pkurucz/opentelem_to_bst_bridge/docs/Arduino Nano - Board.jpg

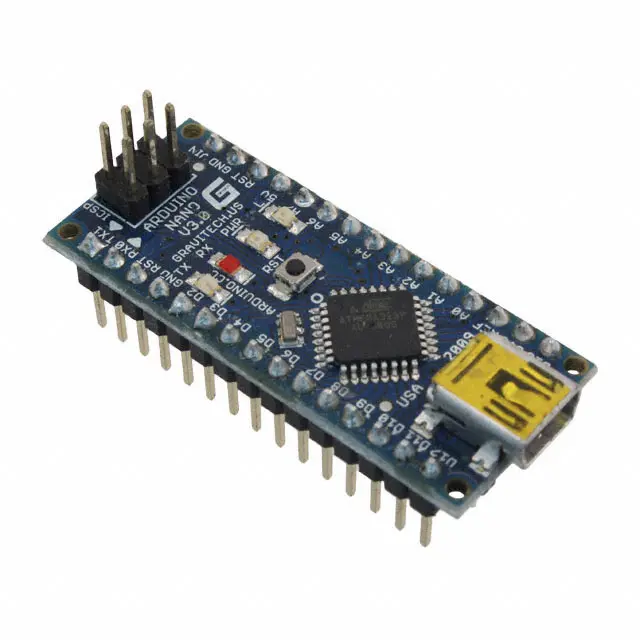
docs/Arduino Nano - Board.jpg
