pkurucz/opentelem_to_bst_bridge/docs/Arduino Nano - Schematic.png

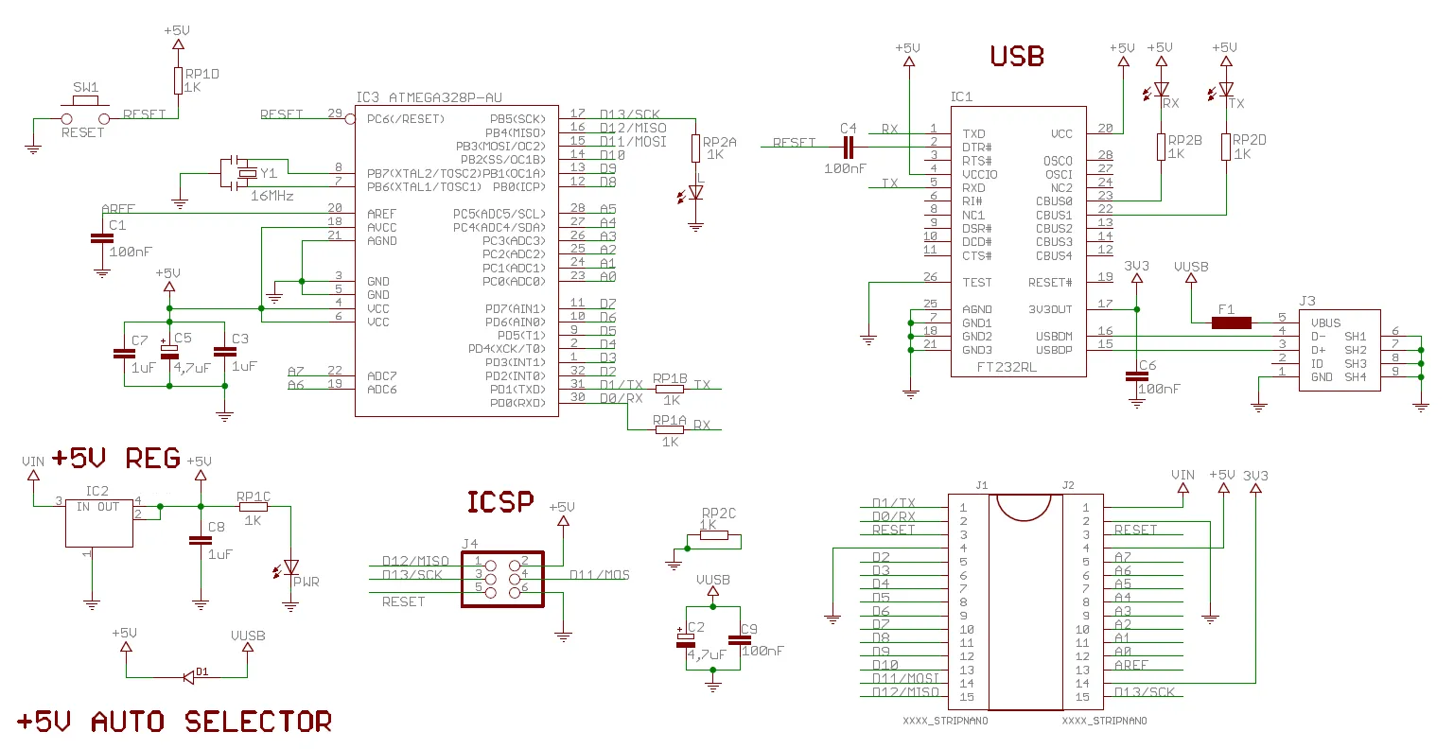
docs/Arduino Nano - Schematic.png
