pkurucz/opentelem_to_bst_bridge/docs/ArduinoNano-3.3.png

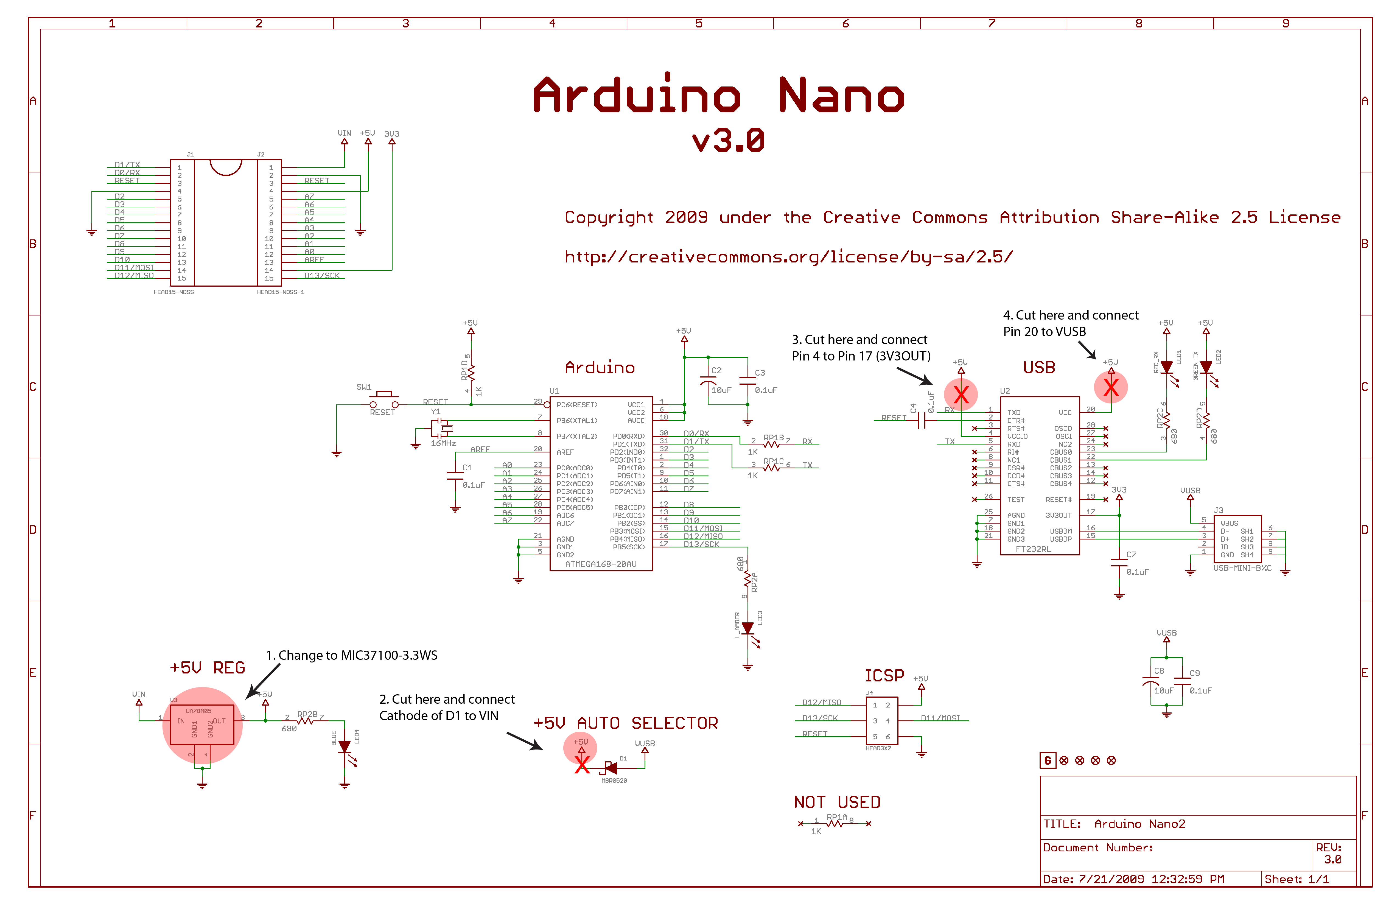
docs/ArduinoNano-3.3.png
