pkurucz/opentelem_to_bst_bridge/docs/Vector Opentelemetry.png

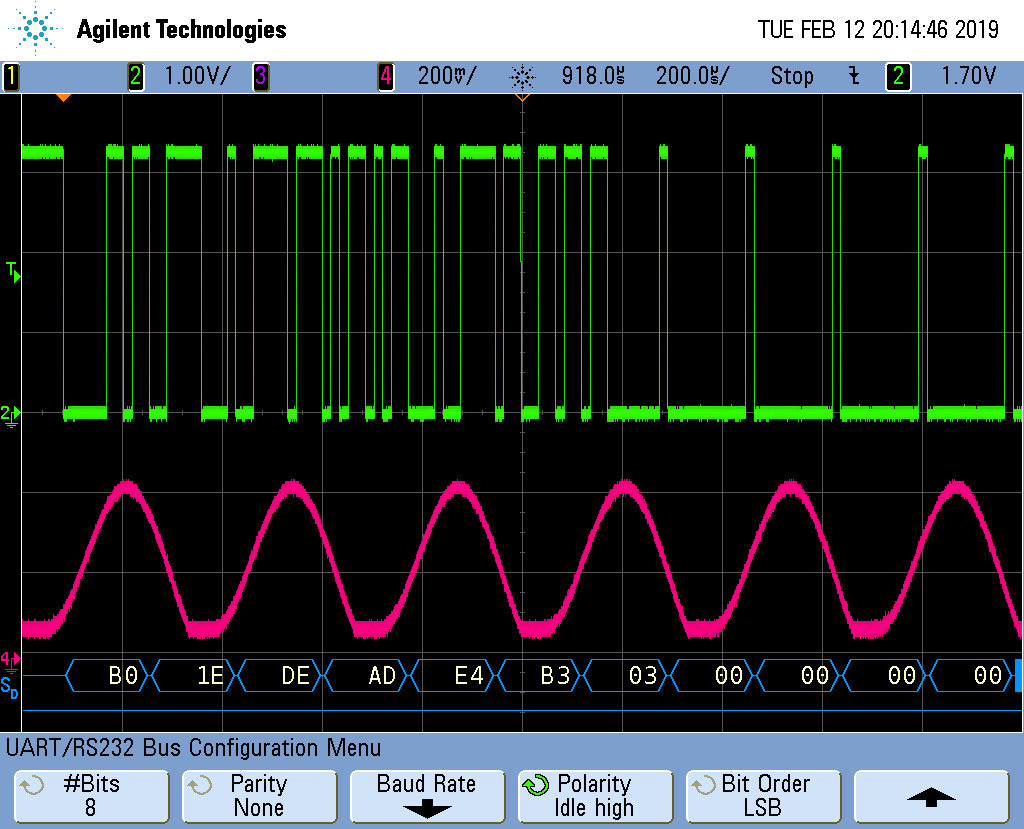
docs/Vector Opentelemetry.png
