pkurucz/opentelem_to_bst_bridge/docs/tbs_bst_wiring_pinout.png

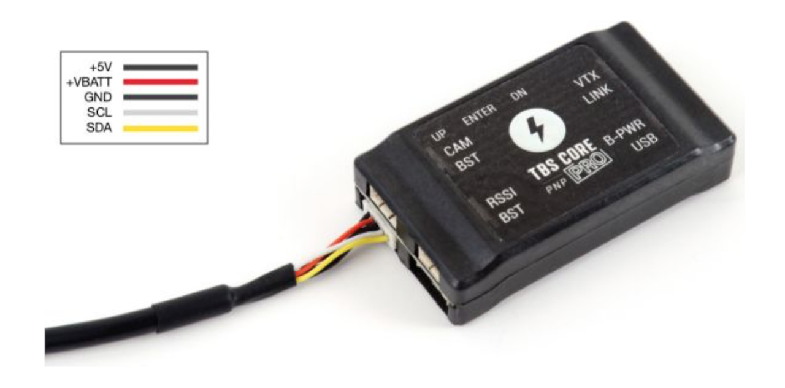
docs/tbs_bst_wiring_pinout.png
