pkurucz/opentelem_to_bst_bridge/(threads)

Thread 2 (2020-08-17):

Usage Help

CorruptName, 2020-08-17:
Is there any way I can use your code to implement a voltage reader for a simple plane?
I want to use an arduino pro mini to read 6s cell voltage and put it out to crossfire receiver's BST port.
Any suggestions? Is this doable?
Thanks!

PS: Thanks for all the work you have done!

pkurucz, 2020-08-17:
Should be very straight forward.  You need 2 resistors to make an external
voltage divider to scale vbatt to either 5V or 3.3V (depending on the
maximum ADC voltage you particular ATMega variant supports).  Read the
value with analogread() (
https://www.arduino.cc/reference/en/language/functions/analog-io/analogread/)
apply and calibration scaling and offset needed.  And look at the
function bst_write_vector_battery(void) in (
https://github.com/pkurucz/opentelem_to_bst_bridge/blob/master/bst_telemetry.cpp).
voltage is a uint16 and is 100 x the voltage.  So, 10.34V would be 1034.

~pk

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

CorruptName, 2020-08-18:
I was curious, How would I send the individual cell voltage?
Essentially I'm trying to re-create this:
[(https://hobbyking.com/en_us/frsky-flvss-lipo-voltage-sensor-with-smart-port-1pc.html?countrycode=US)]
But Instead of S.Port, It would have BST obviously.
I will be using the Arduino Pro Mini for now since it has 8 Analog Inputs (6 if you use A4 & A5 for I2C BST)
and I want to send the voltage data for all cells if possible. If It's not possible or too much work I will settle for combined voltage or maybe just divide total voltage by the number of supposed cells and send out the average cell voltage.

CorruptName, 2020-08-18:
After looking, It seems that Crossfire doesn't have "A4" or "Cell Voltage" only Bat % (which we can't use in BST according to your function notes) or RX Bat (total bat).
Do I have that right?
Thanks!

CorruptName, 2020-08-18:
After some testing, I find that I am unable to get any battery telemetry to the radio. everything seems be set up correctly, since I am getting GPS, GSpd, Hdg, Alt, Sats (though they are all zero) which are not present without arduino. What Am I missing? There is no OpenTelemetry input hooked up but I should still see zero, right?
Thanks, Ryan

CorruptName, 2020-08-19:
Thanks for your help and contribution. I was able to figure it out. If I have time, I may use some of your code to create a library for Arduino to make it easier for those who want to create their own sensors for Crossfire as I have done. If I do find time to create such a library I will certainly contribute it here since it would be derived from your code base.

BTW, It seems that "Bat_" (battery percent) does in fact work over BST unless i misunderstood the code comment.

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

Obviously the provided values are false but the rest is simple.
Thanks Again!
-Corrupt

pkurucz, 2020-08-19:
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

Shiny! Glad to see you got it working.  Sure, feel free to make a library out of the code.  wrt to the BAT%, yeah I saw it in the CRSF code and put it in there as a placeholder to test.  I didn't do it initially because the vector doesn't pass up the bettery percentage through opentelemetry.  Glad to see you can put it to use.

~pk

Giorgo961, 2021-03-12:
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

I need exactly the same thing, but I do not have experiences with Arduino programming. Can I use for it the board with APM32F103C with 128kB flash? And, please, could you send me your FW with this feature?

Giorgo961, 2021-03-29:
> Thanks for your help and contribution. I was able to figure it out. If I have time, I may use some of your code to create a library for Arduino to make it easier for those who want to create their own sensors for Crossfire as I have done. If I do find time to create such a library I will certainly contribute it here since it would be derived from your code base.
Did you have  time to create a library for Crossfire?

CorruptName, 2021-03-29:
I started it but I couldn't honestly tell you how far I made it at this
point. I know it's not finished tho.

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

Giorgo961, 2021-03-29:
> I started it but I couldn't honestly tell you how far I made it at this point. I know it's not finished tho.
> […](#)
> On Mon, Mar 29, 2021, 3:01 AM Giorgo961 ***@***.***> wrote: Thanks for your help and contribution. I was able to figure it out. If I have time, I may use some of your code to create a library for Arduino to make it easier for those who want to create their own sensors for Crossfire as I have done. If I do find time to create such a library I will certainly contribute it here since it would be derived from your code base. Did you have time to create a library for Crossfire? — You are receiving this because you modified the open/close state. Reply to this email directly, view it on GitHub <[#2 (comment)](https://github.com/pkurucz/opentelem_to_bst_bridge/issues/2#issuecomment-809124730)>, or unsubscribe <https://github.com/notifications/unsubscribe-auth/AGFWWL4NGVUXJPXHYNVQLCDTGAXWFANCNFSM4QBHQ4XA> .

OK, and may I ask you to send me the FW you created? I have already the same board 328P. I asked dgatf to create/modify his FW for Crossfire, but up to now it did not work. The board (as a master) sends some data to the receiver, but new sensors did not arrive in TX16S.

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

CorruptName, 2021-03-29:
It's a little annoying to get it working. Later today when I have time I'll
send you what I managed to get working. The reason I stopped messing with
it is because I needed to switch to a different board (likely stm32)
because 328p analog pins are only 10 bit and the current sensors I have
need at least 12 bit. Also I had a baby. I do have working code to post
later tho.

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

Giorgo961, 2021-03-29:
OK, thanks. Congratulation to the baby :-). I am waiting on the board with APM32F103C with 128kB flash, which I mentioned before, but for me it would be enough to have only the battery voltage sensor, if possible.

CorruptName, 2021-03-29:
I never got around to writing the code for the simple voltage divider
circuit so get that ready and I'll send you the code to send it through BST
when I get up.

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

CorruptName, 2021-03-29:
Do you have an email where i can send the code?  I don't want to post it
here until my library is done.

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

Giorgo961, 2021-03-29:
Yes, send it please at juro310@azet.sk

Closed 2020-08-19.

Thread 3 (2020-12-19):

I2C Pull-Up Resistors

yngndrw, 2020-12-19:
Hello,

I was just wondering why you've switched to external pull-up resistors in your code - I couldn't find any notes about why this has been done and if it's necessary or if it's just an experiment that has been left in:
https://github.com/pkurucz/opentelem_to_bst_bridge/blob/master/bst_telemetry.cpp#L158-L170

Thanks,
-Andrew.

pkurucz, 2020-12-20:
The internal pull-ups on my 328p were too weak causing the rise time to be
too low even at 100 KHz.  I left it in incase other arduino MCUs have
stronger pull-ups.

~pk

On Sat, Dec 19, 2020 at 6:58 PM Andrew Young <notifications@github.com>
wrote:

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

yngndrw, 2020-12-20:
Thank you, I'll be using the same microcontroller so I'll be sure to use external pull-ups.

Closed 2020-12-20.
