pkurucz/opentelem_to_bst_bridge/(commit log)

2019-02-01 getting the i2c test building cleanly
2019-02-07 Enabled i2c internal pullups
2019-02-27 Quieted the debug prints. Default debug baud now 230400. Switched opentelemetry uart library to AltSoftSerial (seeing about a 5 percent packet error rate due to dropped charecters
    [bst_telemetry.cpp, opentelem_to_bst_bridge.ino, vector_open_telemetry.cpp]
2019-03-11 Disable flight mode debug prints
